toddvernon/PhotonAlarmSystem/AlarmSystemSchematic.pdf

# Photon Based 48 Channel Alarm System Main Logic Board, Level Shifters, Photo Relay Passthrough

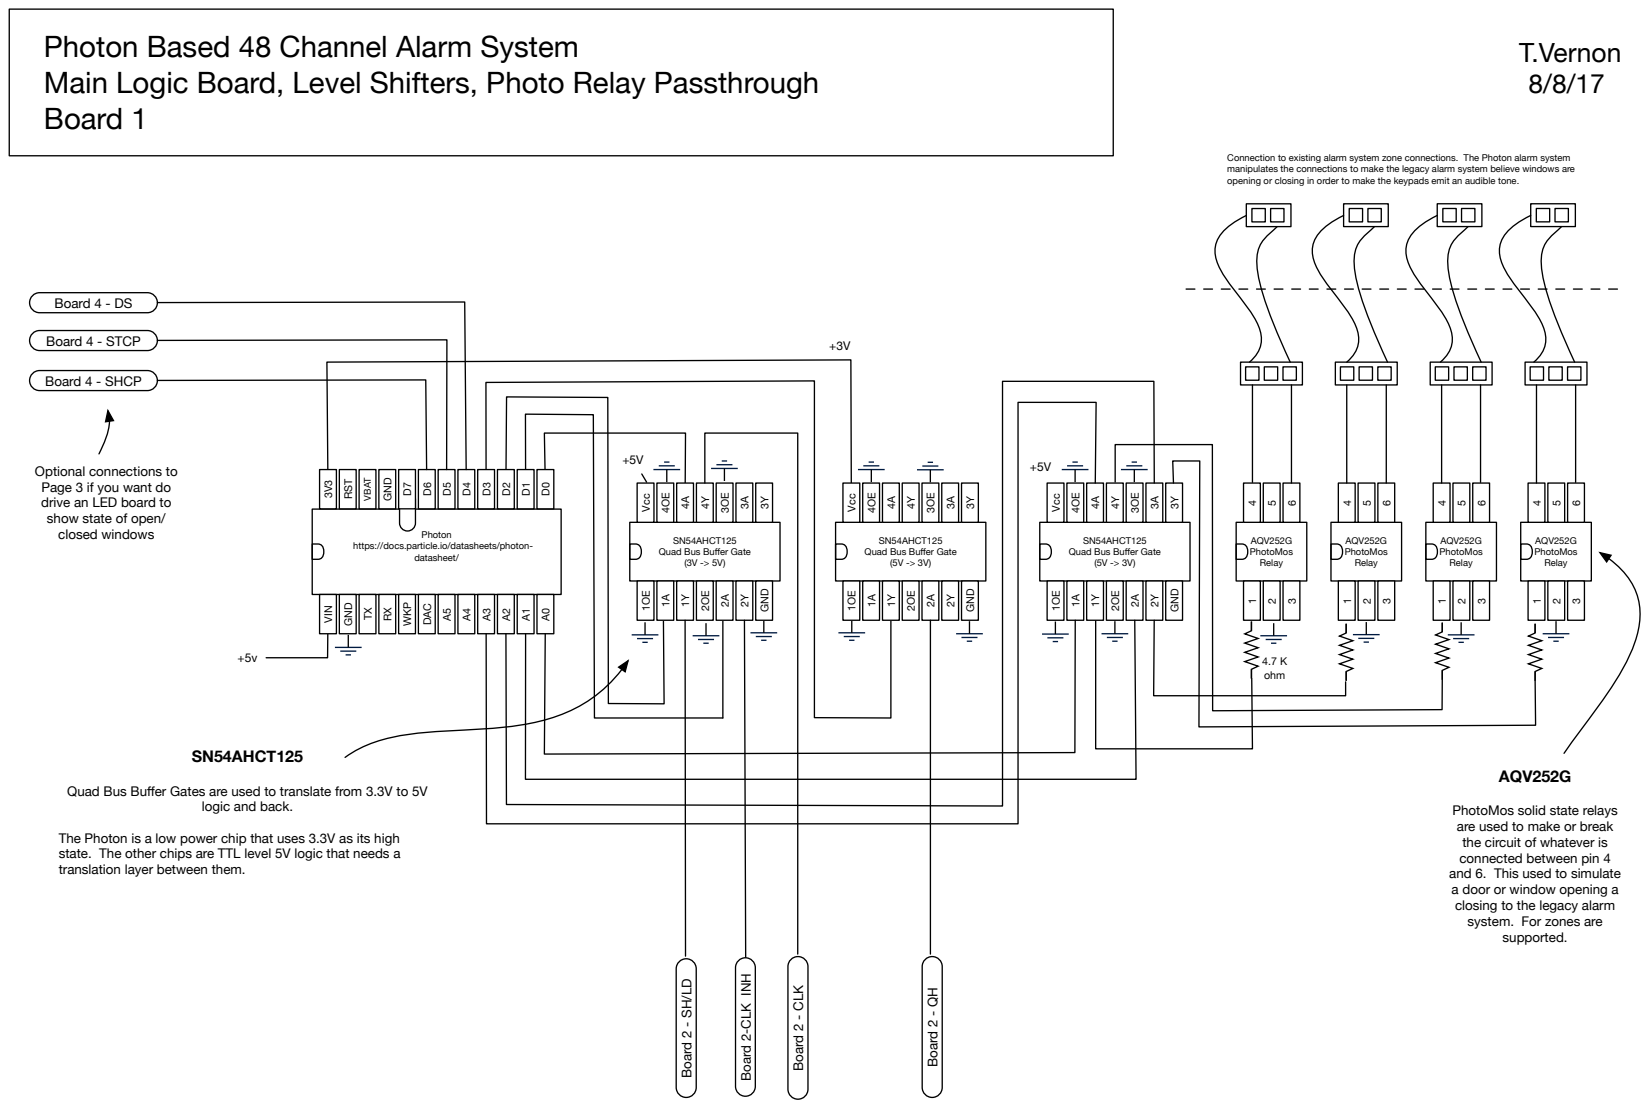
[picture p7: page 1]

Connection to existing alarm system zone connections. The Photon alarm system
manipulates the connections to make the legacy alarm system believe windows are
opening or closing in order to make the keypads emit an audible tone.

Optional connections to
Page 3 if you want do
drive an LED board to

show state of open/
closed windows

https://docs.particle.io/datasheets/photon-

Quad Bus Buffer Gates are used to translate from 3.3V to 5V

PhotoMos solid state relays
are used to make or break
the circuit of whatever is
connected between pin 4
and 6. This used to simulate
a door or window opening a
closing to the legacy alarm
system. For zones are
supported.

The Photon is a low power chip that uses 3.3V as its high
state. The other chips are TTL level 5V logic that needs a
translation layer between them.

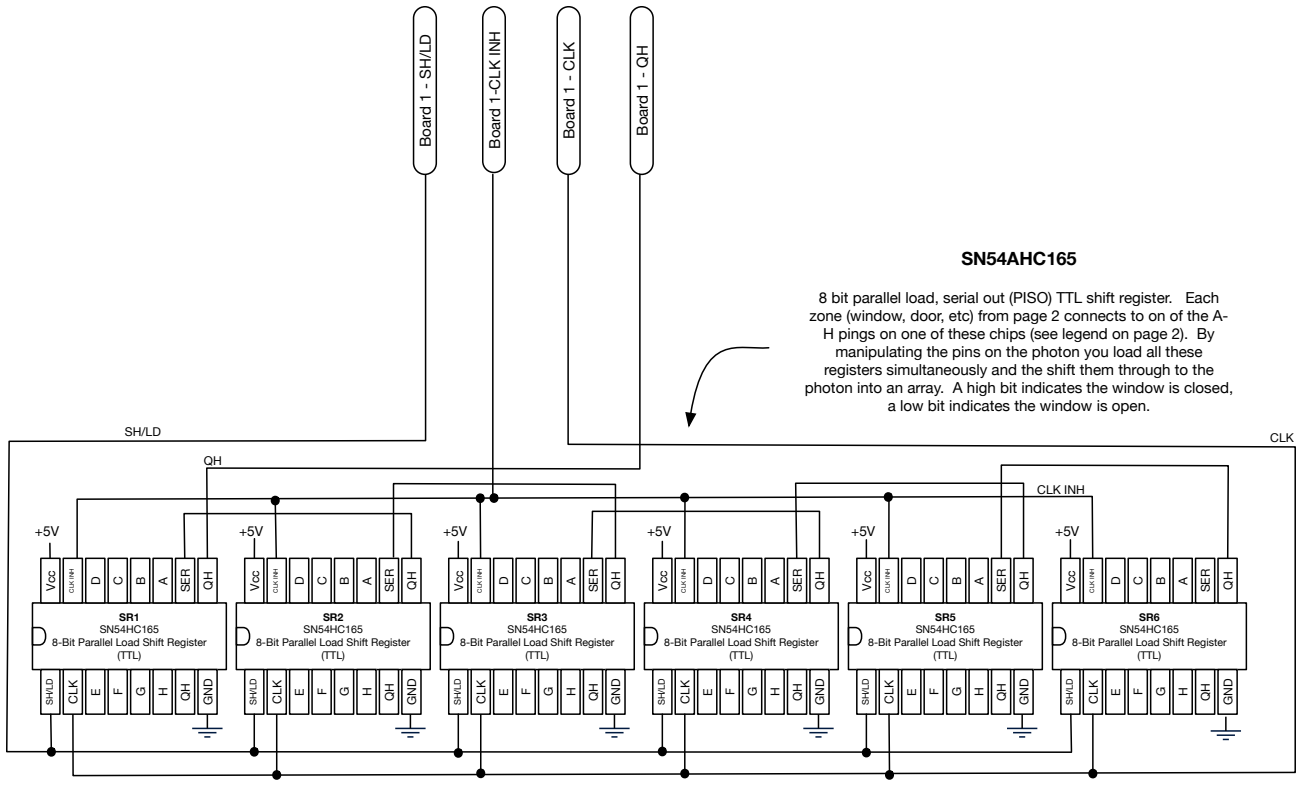
[picture p8: figure]
CLK; CLK INH; SR1 SN54HC165 8-Bit Parallel Load Shift Register (TTL); Vcc; SER; GND QH; SR2 SN54HC165 8-Bit Parallel Load Shift Register (TTL); SR3 SN54HC165 8-Bit Parallel Load Shift Register (TTL); SR4 SN54HC165 8-Bit Parallel Load Shift Register (TTL); SR5 SN54HC165 8-Bit Parallel Load Shift Register (TTL); SR6 SN54HC165 8-Bit Parallel Load Shift Register (TTL); SN54AHC165; a low bit indicates the window is open.; Board 1 - SH/LD; Board 1 - CLK; Board 1 - QH; Board 1-CLK INH

8 bit parallel load, serial out (PISO) TTL shift register. Each zone (window, door, etc) from page 2 connects to on of the A-H pings on one of these chips (see legend on page 2). By manipulating the pins on the photon you load all these registers simultaneously and the shift them through to the photon into an array. A high bit indicates the window is closed,

# Zone Input Shift Register Board Board 2

8/8/17

+5V

Board 2 SR6-A (Chan 48)
Board 2 SR6-B (Chan 46)
Board 2 SR6-C (Chan 45)
Board 2 SR6-D (Chan 44)
Board 2 SR6-E (Chan 43)
Board 2 SR6-F (Chan 42)
Board 2 SR6-G (Chan 41)
Board 2 SR6-H (Chan 40)

Board 2 SR5-A (Chan 39)

Board 2 SR2-H (Chan 8)

Board 2 SR1-A (Chan 7)
Board 2 SR1-B (Chan 6)
Board 2 SR1-C (Chan 5)
Board SR1-D (Chan 4)
Board SR1-E (Chan 3)
Board SR1-F (Chan 2)
Board SR1-G (Chan 1)
Board SR1-H (Chan 0)

Connections to Door
and Window Reed
Switches
(Window Open == Open
Circuit or Zero Volts)

# Zone Input Header Board Board 3

The header board contains screw down contacts to connect the wires coming from the zone reed switches.

The pull-up resistors ensure that the shift registers on page two see a true +5 volts when the window or door is open and 0 volts when the window is closed.

Each zone is connected to the correct shift register pin on page one via this key. Unused zone need to be ignored in software, or jumped in the connection block or the zone window or door will appear open to the software.

Same wiring patter repeated for all zones

8/8/17

# LED Zone Display Board (Optional) Board 4

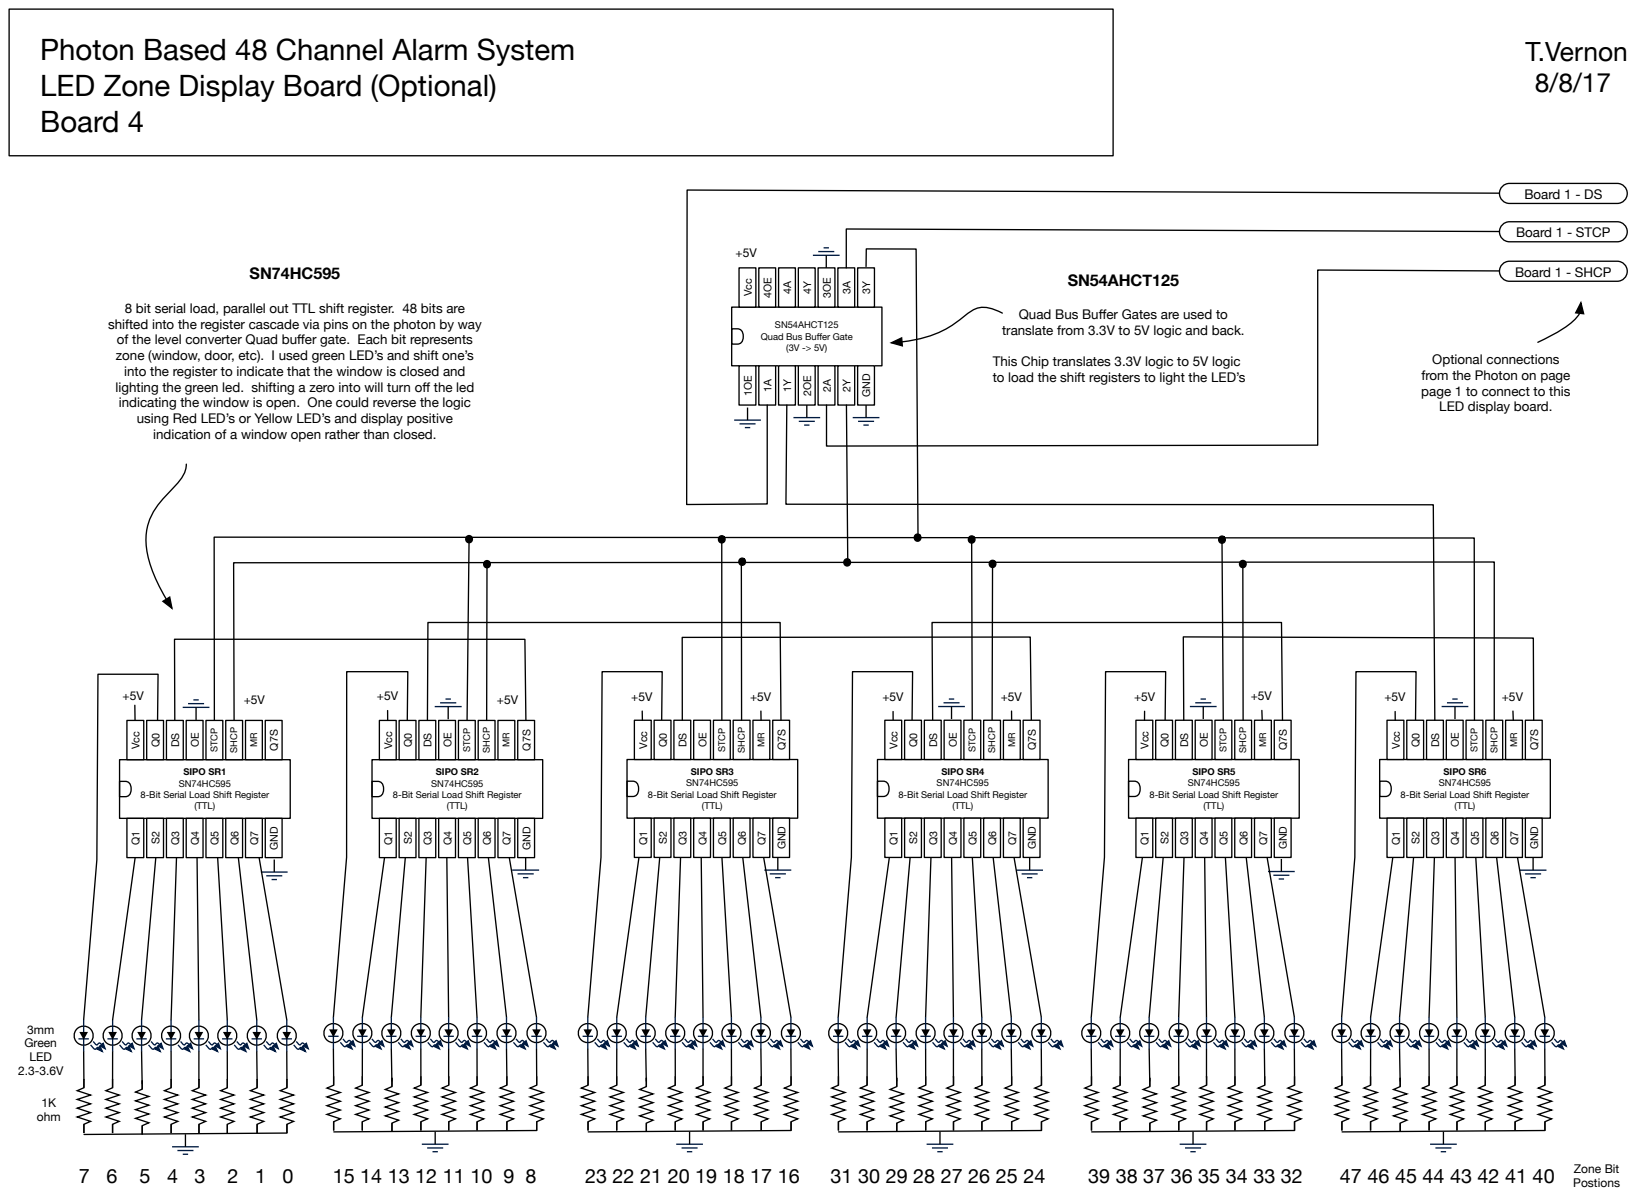
[picture p9: page 4]
SN54AHCT125 Quad Bus Buffer Gate (3V -> 5V); GND; Vcc; SIPO SR2 SN74HC595; (TTL); STCP; SHCP; GND Q7S; SIPO SR3 SN74HC595; SIPO SR5 SN74HC595; SIPO SR6 SN74HC595; 1K ohm; 3mm Green LED 2.3-3.6V; Board 1 - DS; Board 1 - STCP; Board 1 - SHCP; SIPO SR1 SN74HC595; SN54AHCT125; SIPO SR4 SN74HC595; 47 46 45 44 43 42 41 40 Zone Bit; Postions

8 bit serial load, parallel out TTL shift register. 48 bits are
shifted into the register cascade via pins on the photon by way
of the level converter Quad buffer gate. Each bit represents
zone (window, door, etc). I used green LED’s and shift one’s
into the register to indicate that the window is closed and
lighting the green led. shifting a zero into will turn off the led
indicating the window is open. One could reverse the logic
using Red LED’s or Yellow LED’s and display positive
indication of a window open rather than closed.

Quad Bus Buffer Gates are used to
translate from 3.3V to 5V logic and back.

This Chip translates 3.3V logic to 5V logic
to load the shift registers to light the LED’s

Optional connections
from the Photon on page
page 1 to connect to this
LED display board.

8-Bit Serial Load Shift Register
