toddvernon/PhotonAlarmSystem/(commit log)

2017-08-08 Added System Schematic
    A pdf of the as built system
2017-08-10 Added Schematic
